manukautech/XMSnakeRobot/HardwarePlans/README.md

<b>.docx</b> files are the master files. They are the ones to edit if you want to contribute changes.   
<b>.pdf</b> files have a reduced risk of accidental change. Recommended for general use including previewing on GitHub.

Photos of the prototype may look different to the plans.  
The plans include lessons learned from building the prototype.  

For Example: I have tried 2 different kinds of servo-link-ball-joints:

1. The "DUBRO" 2133-Y 2mm Swivel Ball Link comes in packets of 2. <br /> The single ball link cost is about USD 1.00 to USD 2.50 depending on supplier and quantity you buy.
2. The "HobbyKing" 2mm Brass Ball Link (10pieces per bag) SKU 310000121 has a unit cost of about USD 0.33

In my opinion the HobbyKing or similar design is the one to use when 3D printing a "rib" with a suitable mount built into the design. You can see it in the prototype photos as my exercise in trying out ideas for a 3D printed rib. However when going craft modelmaking with plywood, wire and glue the DUBRO is a lot faster to work with. The coloured ball mount with the bolt screwed in becomes the frame mount and the pushrod can be quickly cut and shaped with wire without any need to glue the wire into the ball mount as happens with the "HobbyKing". My experience is that the "DUBRO" cost is worth the time saving.  

## DUBRO Photos ##
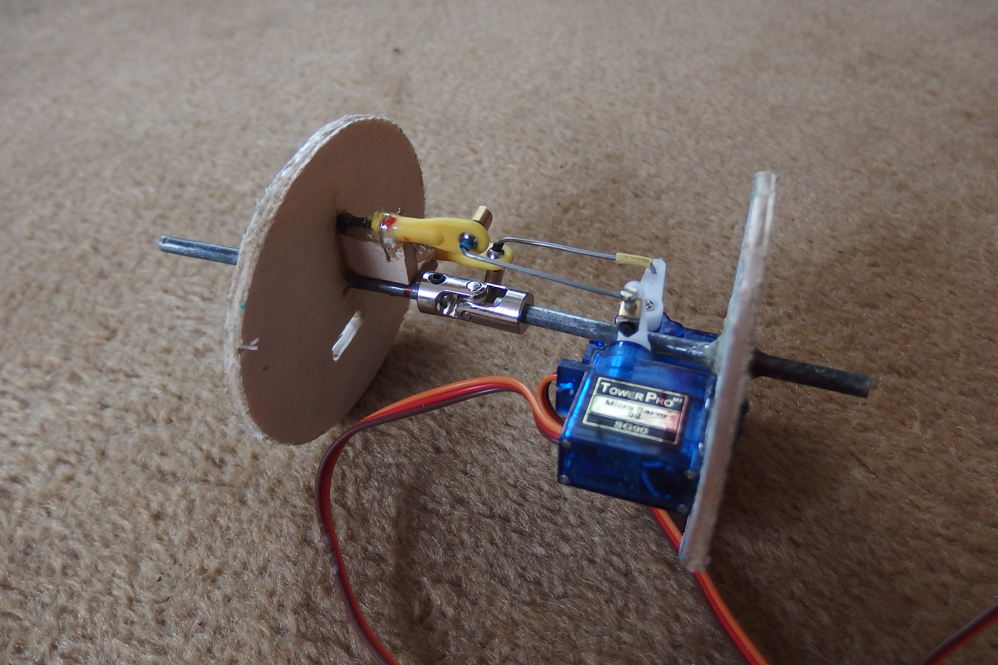
[picture p3: HardwarePlans/Images/Dubro01.JPG]

<br /><br />
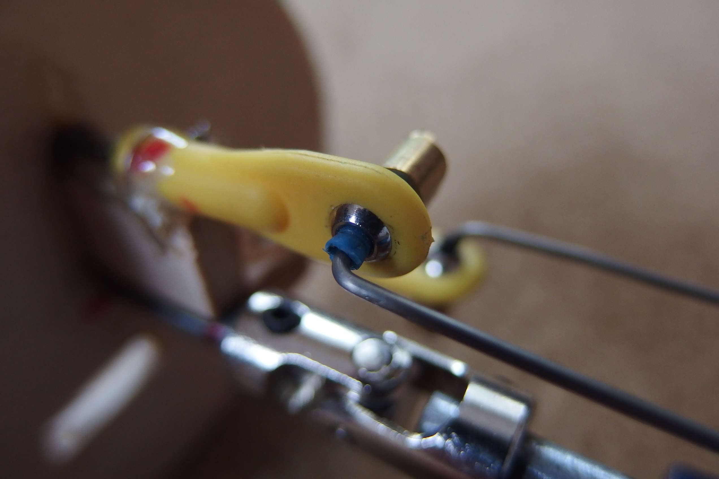
[picture p4: HardwarePlans/Images/Dubro02.JPG]

<br /><br />

## HobbyKing Photos ##
Needs an extra frame mount piece which should in a 3D printed version be part of the rib piece. <br />
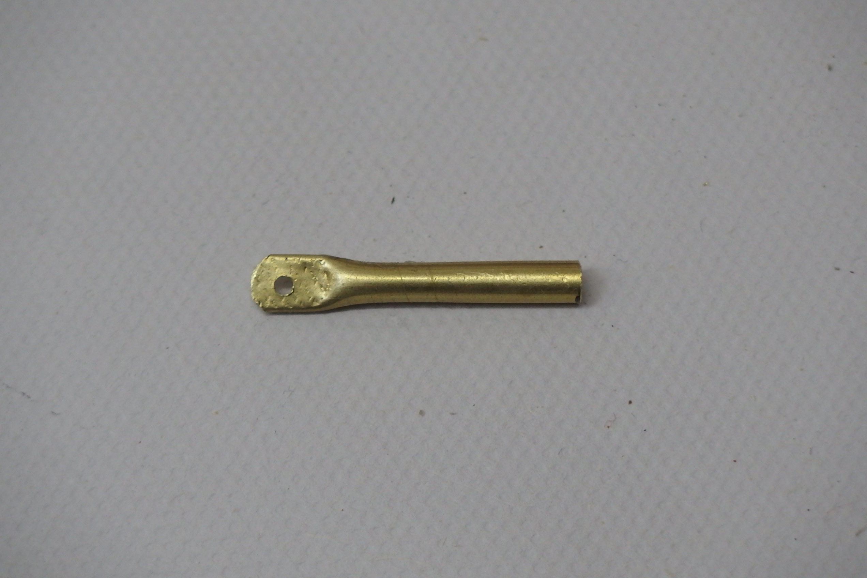
[picture p5: HardwarePlans/Images/Anchor.JPG]

<br /><br />
Anchor mounts to the rib.<br />
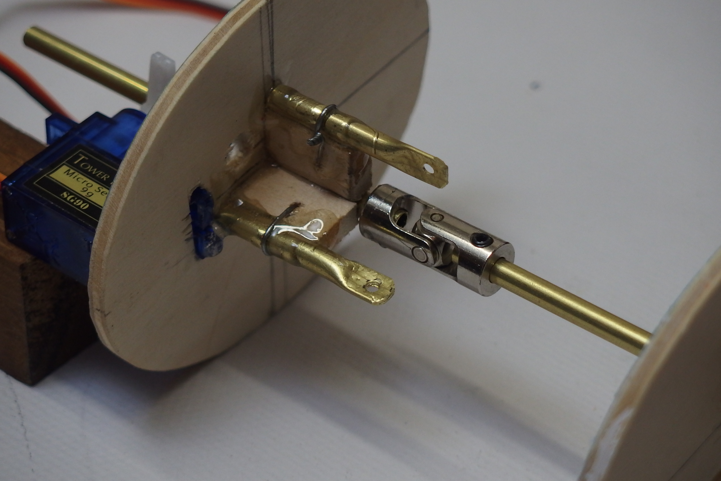
[picture p6: HardwarePlans/Images/AnchorRib.JPG]

<br /><br />
Assembled with the HobbyKing 2mm Brass Ball Links: <br />
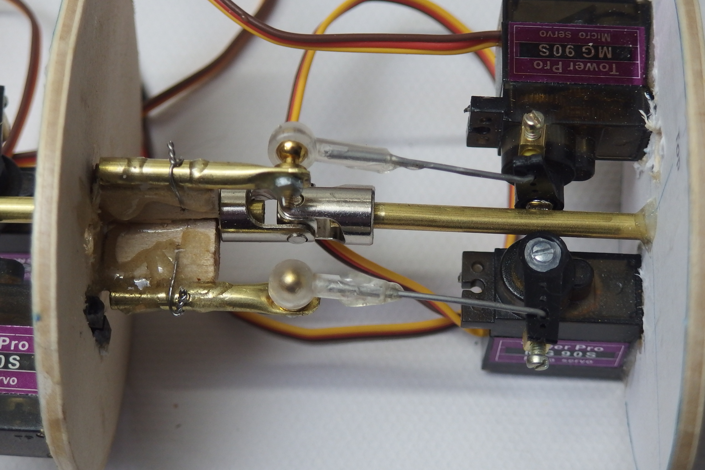
[picture p7: HardwarePlans/Images/Hobbyking.JPG]

<br /><br />
