manukautech/XMSnakeRobot/CodeSpinalCordArduino/README.md

## sketch_SnakeSpinalCord07 ##
Operational as at 26 Dec 2017.
Code for Arduino Nano microcontrollers in use as the servo controllers, responding to control strings sent from a smart phone via bluetooth.  
Issue - minor - we are currently not receiving any data from the "ReceiveOnlySoftwareSerial" code intended for confirmation signals and future sensor data.

Protocol is 6-byte signals.
Variable signalPlace counts them from 0 to 5

Byte 0 - thisBoardId - 'A', 'B', or 'C'  
Byte 1 - servoNumber - range 0 to 7  
Byte 2 - posNeg - '+' or '-'  
Byte 3 - val hundreds  
Byte 4 - val tens  
Byte 5 - val units  

By example:  
"A4+015" - Set servo number 4 in nano group A to + 15 degrees from centre position  
"C1-040" - Set servo number 1 in nano group C to - 40 degrees from centre position

You do not need a snake robot to run this. Connect 1 or more servos for proof of concept.

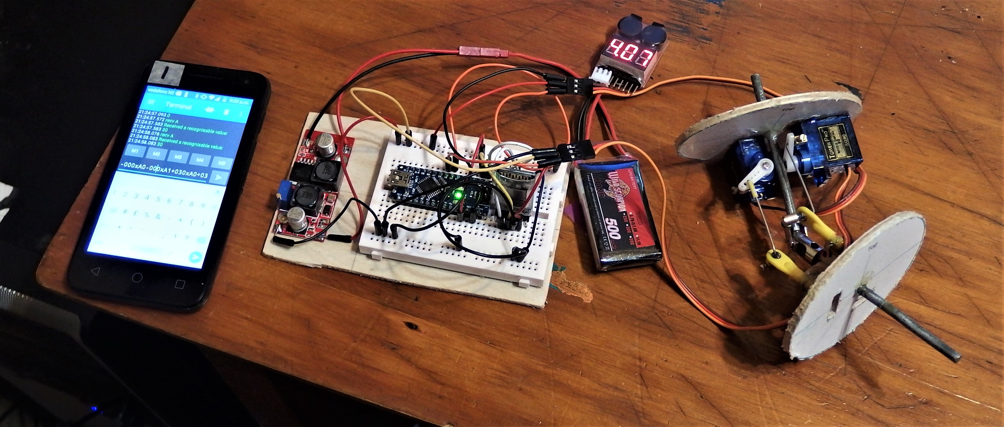
[picture p8: CodeSpinalCordArduino/NanoTesting01_WS.JPG]
  

We are using 38400 baud as a serial communication standard. We use "AT commands" to set the HC-05 to 38400 baud which is a change from its default setting of 9600 baud.  
For first testing with an Android smartphone, we install the App "Serial Bluetooth Terminal" by Kai Morich. This is a download from the Google Play Store. We then type in 6-character test commands. We can enter multiple signals separated by 'x'.  

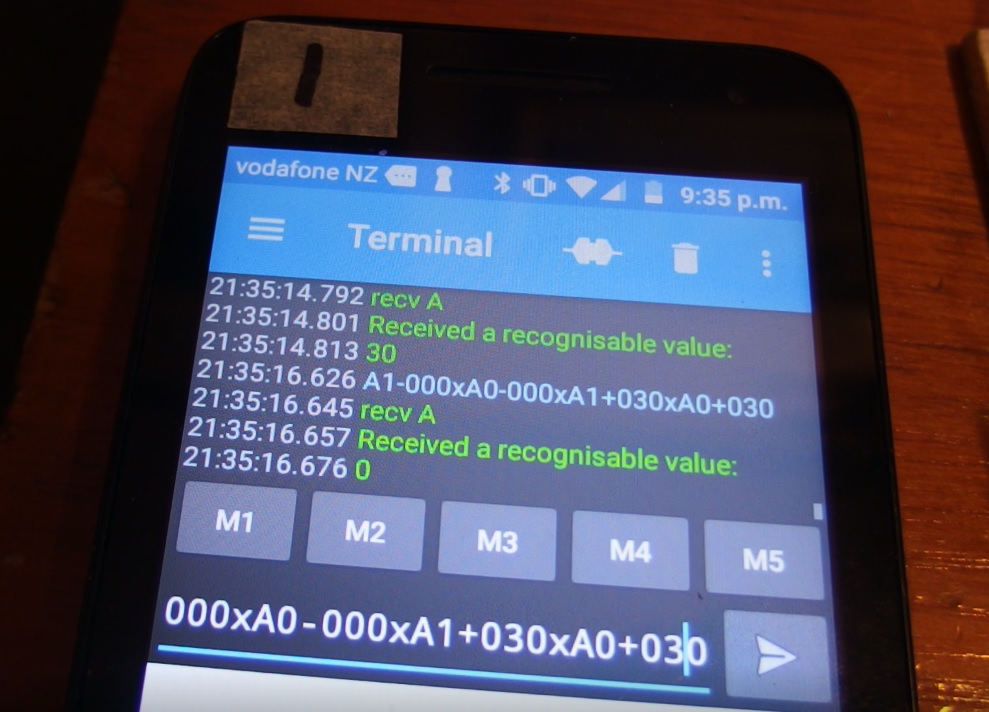
[picture p9: CodeSpinalCordArduino/NanoTesting02_CU.jpg]
  
  
## sketch_SnakeSpinalCord07Wemos  ##
Experiment in using a Wemos as a replacement for an Arduino Nano when I was having servo strange movement issues. I was working through the hypothesis that there was something wrong with the Nano. The Wemos had exactly the same servo issues so that got me focussing on the code where I did, eventually, detect and fix a bug. Wemos works well with almost the same code. I plan to stay with Arduino Nano for now mainly because it has more pins, especially analogue inputs which I may need in the future.
