manukautech/XMSnakeRobot/CodeBrainAndroidJavaScriptDroidScript/Servo-Inchworm_Gait_Worksheet.pdf

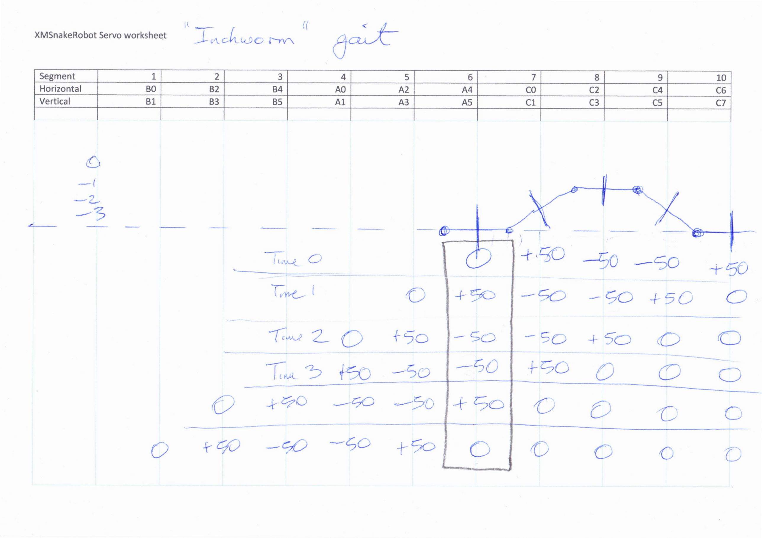
[picture p15: page 1]
