manukautech/XMSnakeRobot/HardwarePhotos/PB180802_RibFront.JPG

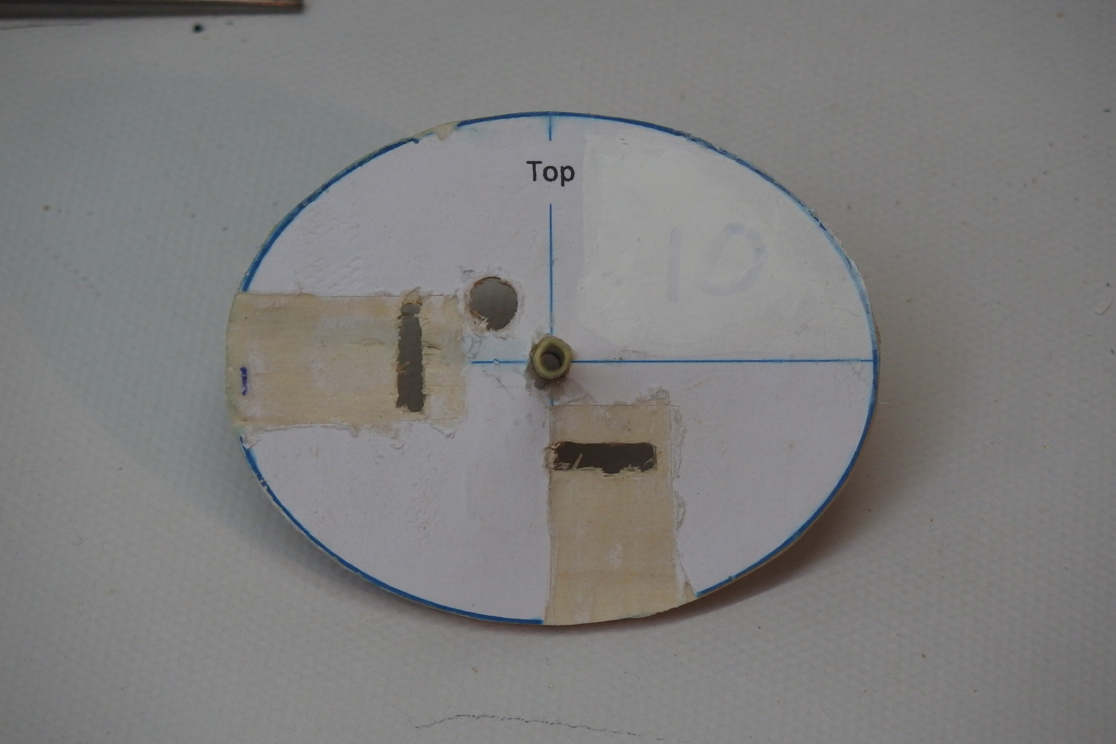
HardwarePhotos/PB180802_RibFront.JPG
