manukautech/XMSnakeRobot/HardwarePhotos/PB180803_RibAngle.JPG

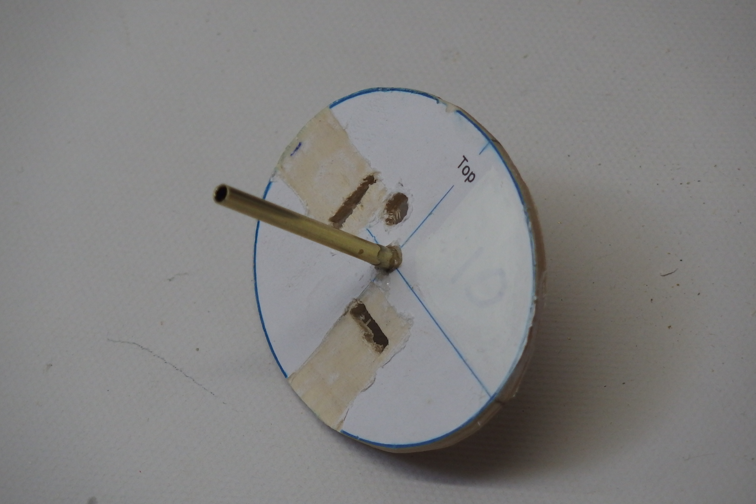
HardwarePhotos/PB180803_RibAngle.JPG
