manukautech/XMSnakeRobot/HardwarePhotos/PB190828_RibFrontWithServos(A).JPG

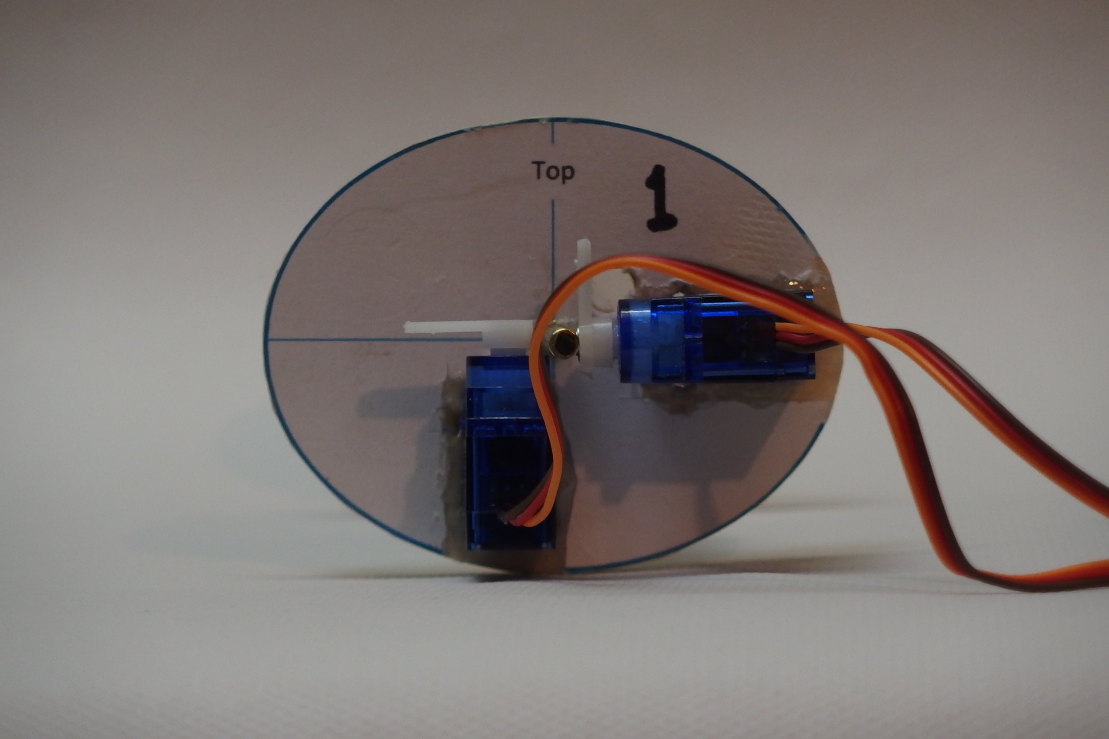
HardwarePhotos/PB190828_RibFrontWithServos(A).JPG
