manukautech/XMSnakeRobot/HardwarePhotos/PB190834_RibRearAngle.JPG

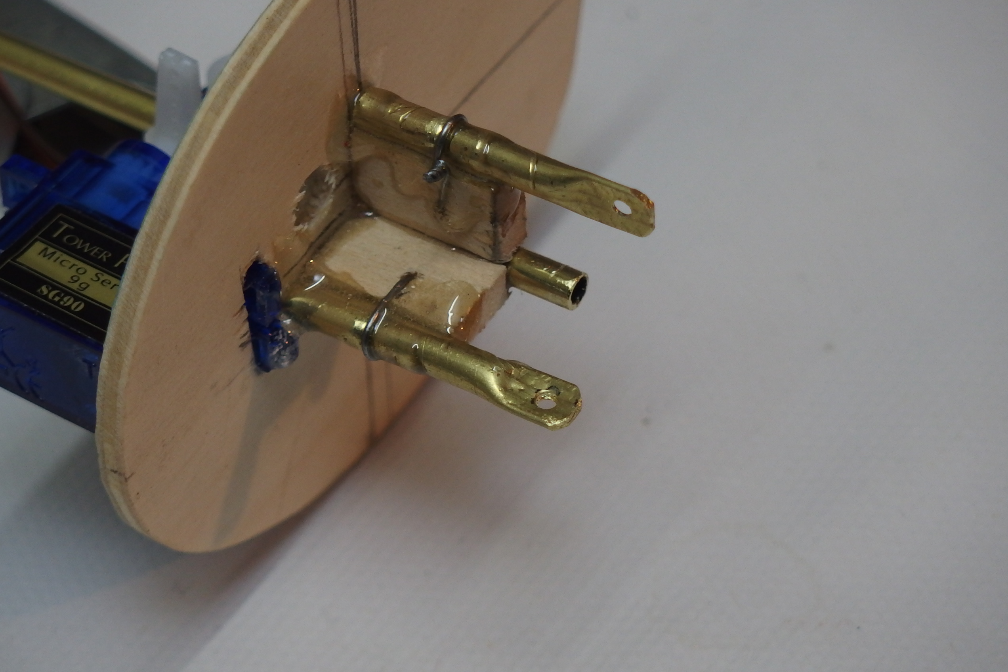
HardwarePhotos/PB190834_RibRearAngle.JPG
