manukautech/XMSnakeRobot/HardwarePhotos/PB190836_RibRearAngle.JPG

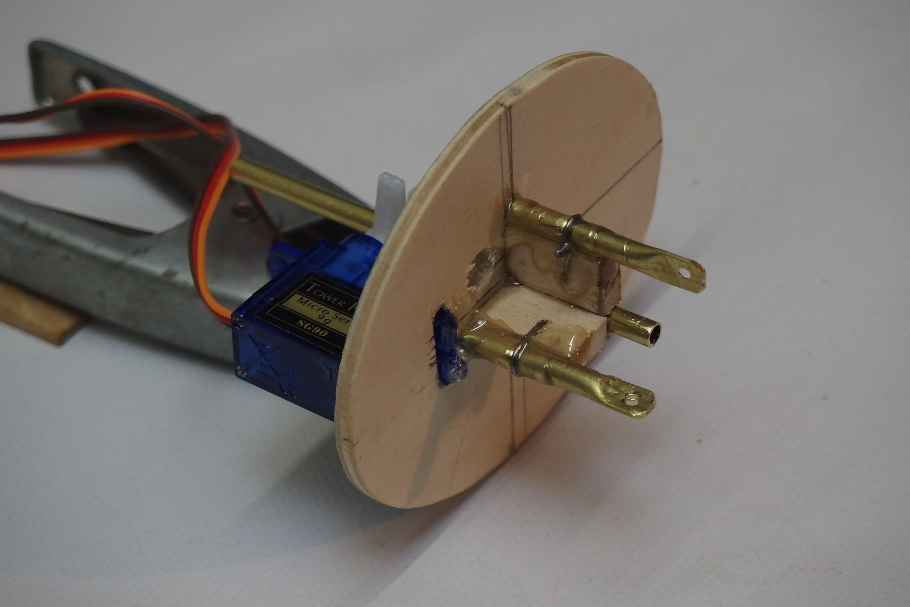
HardwarePhotos/PB190836_RibRearAngle.JPG
