manukautech/XMSnakeRobot/HardwarePhotos/PB190837_RibRear.JPG

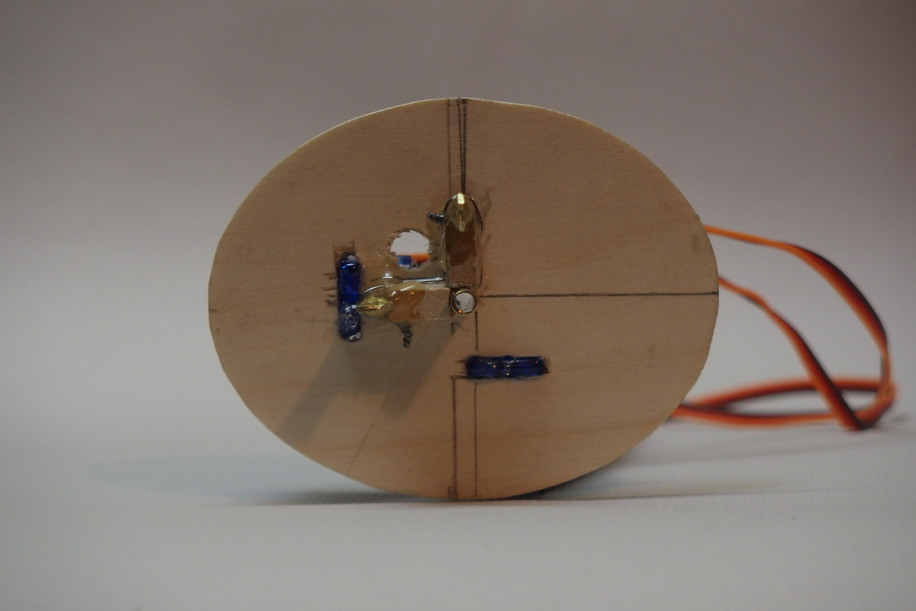
HardwarePhotos/PB190837_RibRear.JPG
