manukautech/XMSnakeRobot/HardwarePhotos/PB190839_RibTopWithServos.JPG

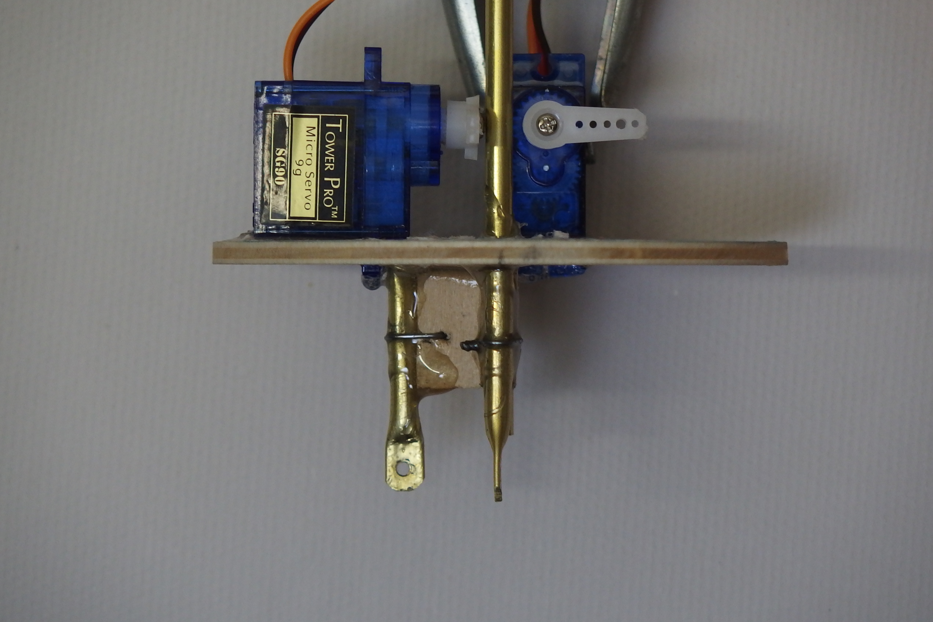
HardwarePhotos/PB190839_RibTopWithServos.JPG
