manukautech/XMSnakeRobot/Images/Assemble_20171203.JPG

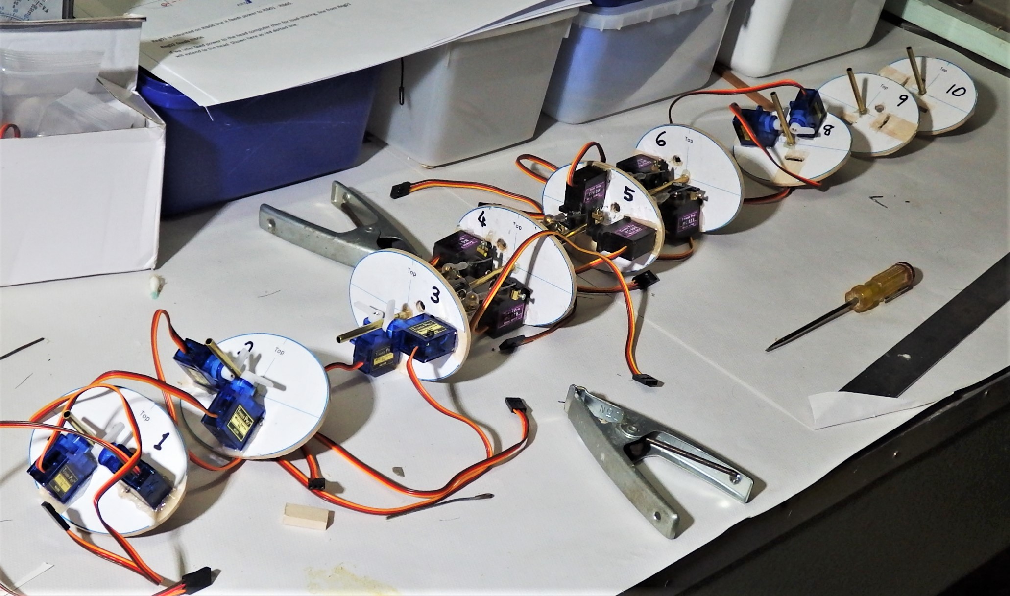
Images/Assemble_20171203.JPG
