manukautech/XMSnakeRobot/Images/Assemble_20171212.JPG

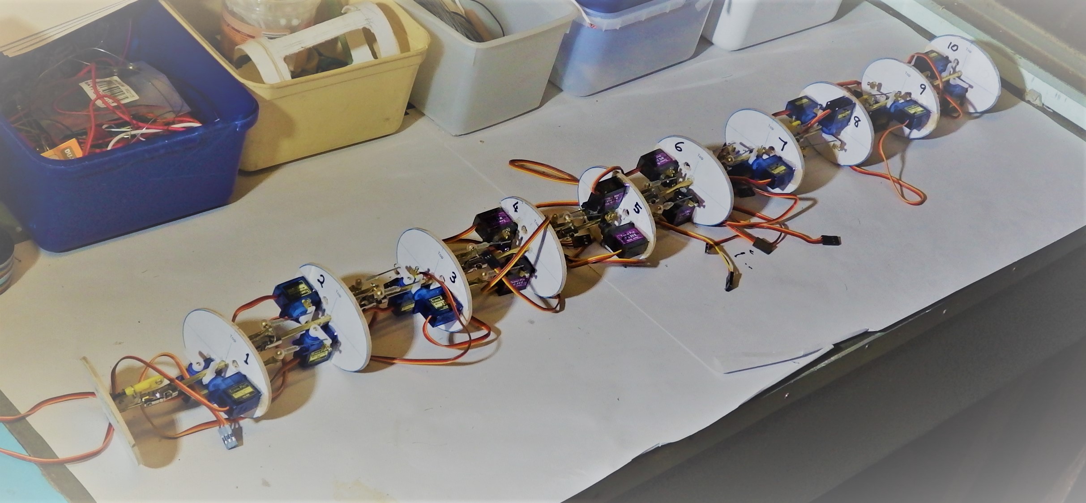
Images/Assemble_20171212.JPG
